flintwinters/headgames/headgames.kicad_sch

## KiCad design headgames.kicad_sch (2026-08-09)

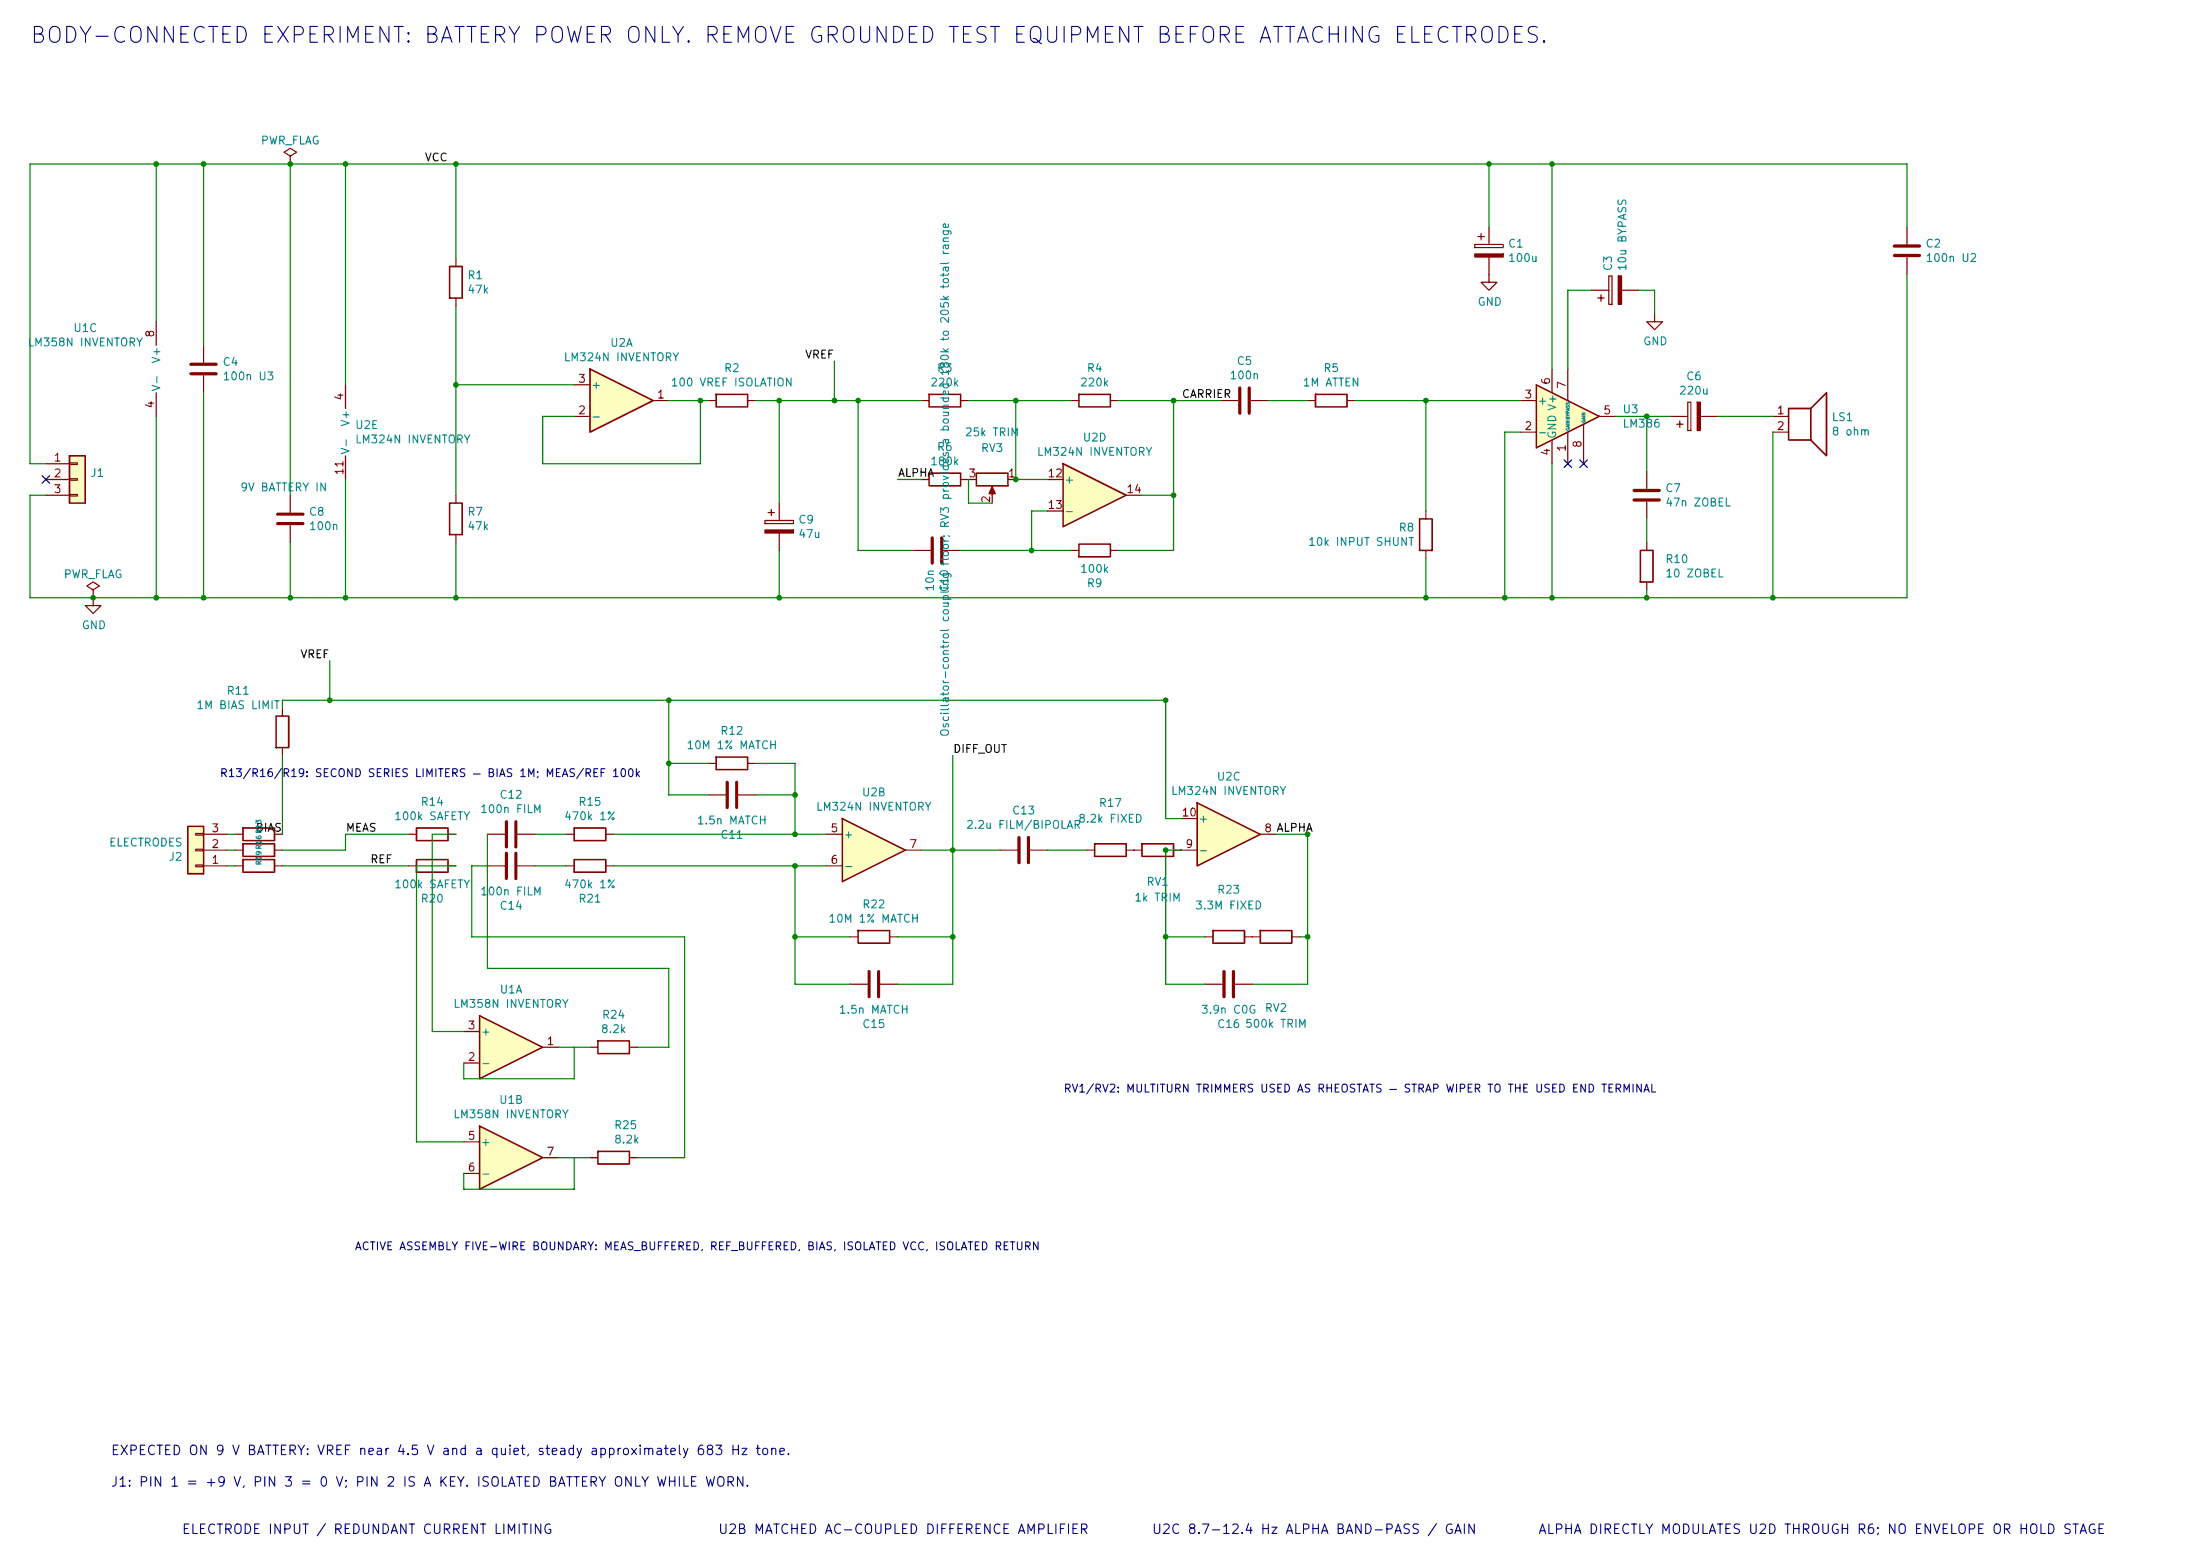
[picture p1: schematic headgames.kicad_sch]

Parts:
C1: 100u
C2: 100n U2
C3: 10u BYPASS
C4: 100n U3
C5, C8: 100n
C6: 220u
C7: 47n ZOBEL
C9: 47u
C10: 10n
C11, C15: 1.5n MATCH
C12, C14: 100n FILM
C13: 2.2u FILM/BIPOLAR
C16: 3.9n C0G
J1: 9V BATTERY IN
J2: ELECTRODES
LS1: 8 ohm
R1, R7: 47k
R2: 100 VREF ISOLATION
R3, R4: 220k
R5: 1M ATTEN
R6: 180k
R8: 10k INPUT SHUNT
R9: 100k
R10: 10 ZOBEL
R11: 1M BIAS LIMIT
R12, R22: 10M 1% MATCH
R13: 1M BIAS SAFETY B
R14, R20: 100k SAFETY
R15, R21: 470k 1%
R16: 100k MEAS SAFETY B
R17: 8.2k FIXED
R19: 100k REF SAFETY B
R23: 3.3M FIXED
R24, R25: 8.2k
RV1: 1k TRIM
RV2: 500k TRIM
RV3: 25k TRIM
U1: LM358N INVENTORY
U2: LM324N INVENTORY
U3: LM386

Connections:
ALPHA: C16.1, R6.2, RV2.1, U2.8
BIAS: R11.2, R13.1
CARRIER: C5.2, R4.1, R9.1, U2.14
DIFF_OUT: C13.2, C15.1, R22.1, U2.7
GND: C1.2, C2.2, C3.2, C4.2, C8.2, C9.2, J1.3, LS1.2, R7.2, R8.2, R10.2, U1.4 (V-), U2.11 (V-), U3.2 (-), U3.4 (GND)
MEAS: R14.2, R16.1
unnamed: C3.1, U3.7 (BYPASS)
unnamed: C5.1, R5.2
unnamed: C6.1, C7.1, U3.5
unnamed: C6.2, LS1.1
unnamed: C7.2, R10.1
unnamed: C10.1, R9.2, U2.13 (-)
unnamed: C11.1, R12.1, R15.1, U2.5 (+)
unnamed: C12.1, R15.2
unnamed: C12.2, R24.1
unnamed: C13.1, R17.2
unnamed: C14.1, R21.2
unnamed: C14.2, R25.1
unnamed: C15.2, R21.1, R22.2, U2.6 (-)
unnamed: C16.2, R23.2, RV1.1, U2.9 (-)
unnamed: J2.1, R19.2
unnamed: J2.2, R16.2
unnamed: J2.3, R13.2
unnamed: R1.2, R7.1, U2.3 (+)
unnamed: R2.2, U2.1, U2.2 (-)
unnamed: R3.1, R4.2, RV3.1, U2.12 (+)
unnamed: R5.1, R8.1, U3.3 (+)
unnamed: R6.1, RV3.2, RV3.3
unnamed: R14.1, U1.3 (+)
unnamed: R17.1, RV1.2
unnamed: R20.1, U1.5 (+)
unnamed: R23.1, RV2.2
unnamed: R24.2, U1.1, U1.2 (-)
unnamed: R25.2, U1.6 (-), U1.7
REF: R19.1, R20.2
VCC: C1.1, C2.1, C4.1, C8.1, J1.1, R1.1, U1.8 (V+), U2.4 (V+), U3.6 (V+)
VREF: C9.1, C10.2, C11.2, R2.1, R3.2, R11.1, R12.2, U2.10 (+)

Notes on the sheet:
ALPHA DIRECTLY MODULATES U2D THROUGH R6; NO ENVELOPE OR HOLD STAGE
EXPECTED ON 9 V BATTERY: VREF near 4.5 V and a quiet, steady approximately 683 Hz tone.
U2B MATCHED AC-COUPLED DIFFERENCE AMPLIFIER
R13/R16/R19: SECOND SERIES LIMITERS — BIAS 1M; MEAS/REF 100k
ACTIVE ASSEMBLY FIVE-WIRE BOUNDARY: MEAS_BUFFERED, REF_BUFFERED, BIAS, ISOLATED VCC, ISOLATED RETURN
BODY-CONNECTED EXPERIMENT: BATTERY POWER ONLY. REMOVE GROUNDED TEST EQUIPMENT BEFORE ATTACHING ELECTRODES.
ELECTRODE INPUT / REDUNDANT CURRENT LIMITING
U2C 8.7-12.4 Hz ALPHA BAND-PASS / GAIN
J1: PIN 1 = +9 V, PIN 3 = 0 V; PIN 2 IS A KEY. ISOLATED BATTERY ONLY WHILE WORN.
RV1/RV2: MULTITURN TRIMMERS USED AS RHEOSTATS — STRAP WIPER TO THE USED END TERMINAL
