flintwinters/headgames/(commit log)

2026-08-08 Establish project guidance and repeatable verification entrypoint
    Document the battery-only analog-feedback motivation, the MVP signal-chain architecture, and the major validation tasks in a concise root AGENTS.md. Make the intended LM324 compromise and its future replacement boundary explicit so later refinements do not accidentally redefine the experiment.
    Add a Typer/Rich manage.py root command, locked Python project dependencies, and local-environment ignores. This creates the required durable location for circuit calculations and engineering checks before schematic values are introduced.
2026-08-08 Provide a safe, immediately viewable audio checkpoint schematic
    Replace the unusable hand-authored legacy KiCad attempt with a clean pin-numbered SVG schematic for the first construction checkpoint only: six-AA battery supply, buffered LM324 virtual ground, LM324 relaxation oscillator, volume control, LM386 output stage, and 8-ohm speaker.
    Keep electrodes explicitly out of this checkpoint and make the battery-only boundary prominent. Document how to export the SVG to PDF, ignore generated viewer/project artifacts, and state that the rejected legacy sheet must not be used for construction.
    Verify the SVG as well-formed XML, render and visually inspect both PNG and PDF outputs, run the proje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
2026-08-08 Add loadable KiCad schematic using only installed stock symbols
    Create the battery-reference, LM324 carrier, and LM386 speaker checkpoint as a KiCad schematic referencing the official Device, Switch, Amplifier_Operational, Amplifier_Audio, and power libraries. Remove every project-authored substitute symbol and keep the electrode path explicitly out of this first safe construction checkpoint.
    Add a portable project symbol-library table based on KICAD9_SYMBOL_DIR and document headgames.sch as the primary project artifact. Verify that KiCad 9.0.9 loads the sheet and exports it through kicad-cli without a parser failure, and pass repository whitespace checks.
    [headgames.sch]
2026-08-08 Correct checkpoint supply, oscillator, and LM386 connectivity
    Remove the battery and switch symbols so BAT+ and GND are explicit externally wired rails, matching the intended construction assumption.
    Reconnect C10 directly between the U1D pin-13 timing node and VREF, clean up the R18/R19 attenuator so R19 shunts the LM386 pin-3 input node to ground, and retain C13 as the local 100 nF U2 supply bypass across BAT+ and GND.
    Move C12 to LM386 pin 7 as the bypass capacitor with its positive terminal toward the bypass pin and ground its negative terminal. Correct U2 supply wiring to pins 6 and 4, and mark gain pins 1 and 8 with explicit no-connect flags. Verify that KiCad CLI loads and exports t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
    [headgames.sch]
2026-08-08 Clarify R19 as the LM386 input shunt
    Move R19 farther below the audio input signal path and provide separate vertical leads between the input junction, resistor, and ground rail. Add an explicit junction at the branch to U2 pin 3 and label the part as the input shunt so the drawing no longer suggests that an unrelated wire passes over the resistor.
    Verify the revised schematic exports successfully through KiCad CLI and passes repository whitespace checks.
    [headgames.sch]
2026-08-08 Add reserved three-pin electrode header
    Add J1 using KiCad's stock Connector_Generic:Conn_01x03 symbol and assign pin 1 to MEAS, pin 2 to REF, and pin 3 to BIAS. Keep all three electrode nets isolated from the current audio checkpoint and label the connector as reserved for the future acquisition stage so it cannot be mistaken for an active body connection.
    Register the installed Connector_Generic library through the portable project symbol table, then verify that KiCad CLI loads and exports the revised schematic and that whitespace checks pass.
    [headgames.sch]
2026-08-08 Wire electrode header into complete analog acquisition chain
    Connect J1 pin 1 MEAS and pin 2 REF through symmetric 100 kΩ safety resistors, 100 nF film coupling capacitors, and 470 kΩ input resistors to U1B. Add matched 10 MΩ/1.5 nF reference and feedback impedances so U1B provides an AC-coupled differential front end centered on VREF. Connect J1 pin 3 BIAS to VREF through a 1 MΩ current-limiting resistor.
    Use U1C for the alpha-selective gain stage with a 2.2 µF/6.8 kΩ high-pass input and 3.3 MΩ/4.7 nF parallel feedback. Add a stock Schottky detector symbol with a 220 kΩ/1 µF envelope network and route ENV into the existing U1D oscillator control input instead of tying that control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
    [headgames.sch]
2026-08-08 Rename positive supply net from BAT+ to VCC
    Use the conventional VCC net name for the externally wired positive supply rail while preserving the schematic's explicit battery-only safety requirements for operation with electrodes attached. Verify the renamed schematic exports successfully through KiCad CLI and passes whitespace checks.
    [headgames.sch]
2026-08-08 Correct stale ENV reference annotation
    Replace the obsolete statement that ENV equals VREF with the accurate invariant: ENV is referenced to VREF and driven by the envelope detector. Apply the same surgical text correction to the user's newly organized native KiCad schematic without staging or otherwise absorbing their broader untracked work.
    Verify the native headgames.kicad_sch loads and exports successfully through KiCad CLI and preserve all existing component placement, wiring, UUIDs, and organizational changes.
    [headgames.sch]
2026-08-08 Make ENV wiring rule explicit on the schematic
    Replace the ambiguous ENV annotation with a direct construction rule: do not wire ENV directly to VREF; R12 and C9 return the envelope node to VREF, D1 drives it, and ENV feeds R16. Apply the identical surgical annotation to the user's organized native KiCad sheet without staging or altering its broader untracked layout work.
    Verify that the native schematic continues to load and export through KiCad CLI and that repository whitespace checks pass.
    [headgames.sch]
2026-08-08 Make the native KiCad schematic the sole design authority
    Remove the obsolete legacy headgames.sch that was retained during migration and add the organized native headgames.kicad_sch as the only schematic source. This eliminates conflicting edits, stale annotations, and uncertainty over which file should be opened or built.
    Preserve the user's native KiCad organization and all current circuit content, including the explicit ENV wiring annotation. Update the README to name the native file as authoritative, then verify it independently by exporting both PDF and BOM through kicad-cli and passing repository whitespace checks.
    [headgames.kicad_sch, headgames.sch]
2026-08-08 Track the native KiCad project and discard stale session metadata
    Stop ignoring headgames.kicad_pro and add the valid KiCad 9 project configuration alongside the sole native headgames.kicad_sch. Remove the local .kicad_prl session cache that retained editor state from the deleted legacy schematic and caused KiCad to prompt for headgames.sch.
    Preserve the active native schematic lock file, validate the project JSON, verify the native schematic exports through kicad-cli, and pass repository whitespace checks. Users should now open headgames.kicad_pro rather than the obsolete recent-file entry for headgames.sch.
2026-08-08 Refresh concise project philosophy and architectural guidance
    Update AGENTS.md to identify the native KiCad schematic as the sole authority and capture the durable MVP architecture: three-electrode battery-powered acquisition, LM324 reference/differential/filter/carrier roles, passive ENV detector, LM386 output, and an entirely analog feedback loop.
    Make the ENV/VREF invariant and body-connected electrical safety boundary explicit, retain the instrumentation-amplifier upgrade boundary, and reduce current work to the three major validation phases. Remove the inaccurate claim that placeholder manage.py calculations are jointly authoritative and add compact KiCad/source-of-truth workflow guida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
2026-08-08 Document the board as externally wired
    Remove all tracked references to battery or AA-cell operation from the authoritative schematic, project guidance, README, and build-now visual. Rename the illustrated supply rail consistently to VCC and depict the source as an isolated wired 9 V DC input.
    Retain the body-connected safety invariant in terms appropriate to a wired board: the external DC supply must remain isolated from mains earth and USB while electrodes are attached, and grounded or non-isolated equipment must be disconnected.
    Verification: python3 manage.py test; xmllint --noout BUILD_NOW.svg; git grep confirms no battery, BAT+, or AA terminology remains in tracked sources; kicad-cli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
    [headgames.kicad_sch]
2026-08-08 Fix LM386 carrier input connectivity
    Remove the unintended ground leg from the attenuated carrier node so the C11/R18 signal path reaches LM386 pin 3. Preserve the intended R19 input shunt and grounded inverting input, while giving C14 an independent local ground symbol so supply decoupling no longer relies on the faulty shared wire.
    Replace the placeholder project test with a KiCad-netlist connectivity check. The root manage.py entrypoint now verifies that R18 and R19 meet U2 pin 3, that U2 pin 2 remains grounded, that pin 3 is not grounded, and that C14 still returns to ground. Temporary verification artifacts are created and removed within the project directory.
    Verified with python3 ma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
    [headgames.kicad_sch]
2026-08-08 Restore LM386 input path after schematic relayout
    Accept the newly saved authoritative KiCad layout while restoring the carrier-to-audio connectivity invariant lost during the overwrite. Remove the ground leg that shorted the R18/R19/U2 pin 3 node, leaving R19 as the intended input shunt and U2 pin 2 as the grounded inverting input.
    Separate C14 supply decoupling from the signal path by returning its negative terminal through a dedicated GND symbol. This prevents the bulk-decoupling connection from recreating a conductive short between the LM386 non-inverting input and ground.
    Verified the current schematic with python3 manage.py test, a direct kicad-cli netlist export, kicad-cli ERC, Pyth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
    [headgames.kicad_sch]
2026-08-08 Isolate buffered VREF from reservoir capacitance
    Insert R17 as a 100 ohm series isolation resistor between the U1A voltage-follower output and the distributed VREF rail. Keep U1A feedback connected on the amplifier side of R17 so the 47 uF C1 reservoir cannot sit inside the follower loop or directly load the LM324 output.
    Extend the root manage.py connectivity verification to require the follower feedback topology, both sides of R17, and electrical separation between C1 and U1A's output. This turns the stability boundary into a durable schematic invariant.
    Verified with 'uv run ./manage.py test', KiCad 9 netlist export through the test harness, and 'git diff --check'. KiCad ERC still repor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
    [headgames.kicad_sch]
2026-08-08 Bound LM386 carrier drive below clipping demand
    Increase R18 from 100 kohm to 1 Mohm while retaining the 10 kohm input shunt and AC coupling. With the LM386's specified 50 kohm input resistance included in parallel with R19, the gain-20 amplifier now requests approximately 0.165 V/V of speaker-output swing for each volt of carrier swing instead of exceeding the available battery rail.
    Refactor schematic extraction to return component values together with connectivity, add compact resistor-value parsing, and calculate the complete source-divider-plus-LM386 gain in the root verification command. Fail verification if the ideal carrier-to-output demand exceeds 0.2 V/V so future value edits cann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
    [headgames.kicad_sch]
2026-08-08 Stabilize LM386 output with series Zobel network
    Add C16 at 50 nF and R20 at 10 ohms as a series branch from LM386 pin 5 to ground, matching the output stabilization network in the manufacturer's gain-20 application. Branch before the speaker coupling capacitor so the network damps high-frequency load reactance without placing DC across the speaker or turning C16 into a direct capacitive output load.
    Extend manage.py verification to require C16 on the amplifier output net, the isolated C16/R20 midpoint, R20's ground return, and the authoritative 50 nF and 10 ohm values. This prevents topology regressions such as a parallel RC branch or a capacitor connected directly from output to ground.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
    [headgames.kicad_sch]
2026-08-08 Define the isolated 9 V battery power contract
    Replace the schematic's ambiguous loose VCC and ground stubs with a keyed three-position J2 battery interface. Pin 1 is the positive 9 V feed, pin 3 is battery return, and pin 2 is deliberately unused as a polarization key. Add source flags at the connector-fed rails so KiCad ERC can distinguish an intentional external source from an accidentally undriven power network.
    Make the operating voltage and isolation requirement explicit in both the connector metadata and the on-sheet safety notes. This removes guesswork around LM324 headroom, LM386 supply range, capacitor polarity, and electrode bias-current bounds while retaining the project's batte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
    [headgames.kicad_sch]
2026-08-08 Harden the physiological pickup and alpha detector path
    Replace the authoritative LM324N population with the pin-compatible TLC274CN low-bias CMOS quad amplifier. The 9 V single-supply topology and existing package boundary remain intact, while picoamp-scale input bias avoids the large 10 MΩ acquisition-network error inherent to the bipolar LM324. Retain LM324 only as an explicitly documented artifact-test fallback rather than the physiological pickup configuration.
    Separate the U1C alpha-band corners by changing C7 to 2.7 uF and C8 to 3.9 nF. With the existing 6.8 kΩ input and 3.3 MΩ feedback resistors, the calculated high-pass and low-pass corners are 8.67 Hz and 12.36 Hz instead of tw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
    [headgames.kicad_sch]
2026-08-08 Restore the inventory-first LM324N implementation
    Undo the unavailable TLC274CN population decision while preserving the independently valid power-interface, alpha-band, detector, and verification improvements. Restore LM324N consistently across all five schematic units, the title block, README, and architectural guidance.
    Make the inventory constraint executable by changing the root verification entrypoint to require LM324N for U1. Document its bipolar input-bias, offset, and noise limitations honestly at the 10 MΩ acquisition impedance, and retain a clean future replacement boundary without making an unstocked part mandatory for the MVP.
    Verification: python3 manage.py test passes; KiCa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
    [headgames.kicad_sch]
2026-08-08 Separate the battery inlet from supply decoupling
    Move J2 into a dedicated inlet block at the far left of the schematic and route its positive and return conductors around the outside of the circuit. The keyed pin now has an isolated, visible no-connect marker, and neither battery conductor passes through a component body or field.
    Restore C2 as an independent vertical bypass branch directly between VCC and ground. Shorten J2's displayed value to avoid colliding with C2 while retaining the complete polarity, keying, and isolation contract in the connector description and the on-sheet safety annotation.
    Update the durable J2 value assertion to match the concise displayed field. Verification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
    [headgames.kicad_sch]
2026-08-08 Replace the passive alpha detector with an LM358N precision stage
    Use the inventory LM358N as a two-stage analog envelope front end. U3A now drives the existing 1N5711 inside its feedback loop so the op amp compensates the Schottky forward drop instead of requiring the filtered alpha signal to overcome it directly. Keep R12 and C9 as the authoritative 220 ms hold/release network referenced to VREF, and expose that held voltage as ENV_RAW.
    Use U3B as a unity-gain buffer between ENV_RAW and the carrier-control input. This prevents the oscillator summing resistor from loading the detector capacitor while retaining an entirely analog feedback path. Add C17 as local 100 nF LM358N supply decoupli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
    [headgames.kicad_sch]
2026-08-08 Add independent current limiting at every electrode connection
    Place a second physical series resistor immediately after each J1 electrode pin so a single resistor short cannot entirely remove the intended current limiting. MEAS and REF now each use two 100 kohm safety resistors for a nominal 45 microamp 9 V upper bound; BIAS uses two 1 Mohm resistors for a nominal 4.5 microamp upper bound.
    Keep the connector-side nets deliberately limited to J1 and the outer resistor, then join each outer resistor to the existing inner limiter on a separate circuit-side net. This makes the no-bypass invariant explicit in the native netlist rather than relying on annotations.
    Extend manage.py to verify the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
    [headgames.kicad_sch]
2026-08-08 Clarify the new detector and electrode safety annotations
    Replace long internal detector net names with compact DRV and HOLD labels so the precision-feedback connections remain legible on the A3 sheet. Shorten the D1 display value while retaining the exact 1N5711 part identity in both the schematic value and automated invariant.
    Keep the tightly spaced connector-side resistors identifiable by compact reference labels and add one authoritative callout stating their roles and values, rather than allowing three repeated long value strings to obscure the electrode wiring.
    Verified the rendered schematic visually after native SVG export, then reran python3 manage.py test for connectivity and ze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
    [headgames.kicad_sch]
2026-08-09 Add bounded alpha-band corner tuning
    Introduce fixed-plus-trimmer resistance in both alpha filter corner networks so calibration cannot remove the stage's limiting resistance. The high-pass uses 6.2 kOhm fixed plus a 1 kOhm multiturn trim for an approximately 8.19-9.51 Hz range with the existing 2.7 uF capacitor. The low-pass uses 3 MOhm fixed plus a 500 kOhm multiturn trim for an approximately 11.66-13.60 Hz range with the existing 3.9 nF capacitor.
    Represent each external three-terminal trimmer as a two-terminal rheostat in the authoritative schematic and add an explicit assembly instruction to strap the wiper to the used end terminal. This gives a defined failure tendency if wiper contac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
    [headgames.kicad_sch]
2026-08-09 Normalize adjustable filter parts to common values
    Replace the difficult-to-source 2.7 uF alpha high-pass capacitor with a common 2.2 uF film or bipolar value and compensate with an 8.2 kOhm fixed resistor. Together with the existing 1 kOhm trim this preserves a bounded approximately 7.86-8.82 Hz high-pass adjustment range.
    Replace the 3 MOhm low-pass resistor with the readily available 3.3 MOhm value. Retaining the 500 kOhm trim provides an approximately 10.74-12.37 Hz low-pass adjustment range that remains wholly above the maximum high-pass corner.
    Normalize the LM386 output stabilization capacitor from nominal 50 nF to standard 47 nF while retaining the 10 Ohm series resistor. Update th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
    [headgames.kicad_sch]
2026-08-09 Normalize the precision detector diode to 1N4148
    Replace the specialized 1N5711 low-level Schottky with the ubiquitous 1N4148 small-signal silicon diode. D1 remains inside the LM358 precision-detector feedback loop, so the amplifier compensates the higher silicon forward drop rather than imposing it as an envelope threshold.
    Prefer the 1N4148's low reverse leakage for the held envelope node. This keeps the detector release primarily controlled by the intentional 220 kOhm and 1 uF network instead of allowing a generic Schottky's leakage to become a significant parallel discharge path.
    Update the schematic description, architectural invariant, and durable component assertion. Preserve the wa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
    [headgames.kicad_sch]
2026-08-09 Add reproducible EEG-path AC circuit simulation
    Introduce a deterministic complex-impedance model of the matched acquisition
    and alpha-filter stages. Build the model from values exported from the sole
    authoritative KiCad schematic so that simulation cannot silently drift into a
    parallel circuit definition.
    Exercise every trimmer corner in the root manage.py test entrypoint, bound the
    predicted response peak and gain, and verify that a 200 uV peak differential
    fixture remains within conservative LM324 output headroom. Add simulate-eeg as
    the human-readable reporting command for representative 10-100 uV signals.
    The report intentionally exposes the important result that the cascaded
    response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
2026-08-09 Document system-level EEG simulation limits
    Extend the simulation regression to preserve the nominal full-cascade -3 dB
    span, rather than validating only individual RC corner calculations. Report
    that span alongside peak frequency and gain so future component changes reveal
    whether system selectivity actually improves.
    Document the 20 kohm electrode-source assumption, representative 10-100 uV
    peak fixtures, expected ALPHA-node amplitudes, and the ideal small-signal
    model's explicit exclusions. Record the central finding that the current
    3.69-14.71 Hz response is broad and peaks below alpha, leaving artifact,
    mains-pickup, tolerance, and real LM324 behavior for isolated bench testing.
    Also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
2026-08-09 Model alpha distinguishability under simultaneous artifacts
    Extend the schematic-driven frequency-domain solver from balanced differential
    inputs to the full ideal-op-amp nodal solution with independent MEAS and REF
    source impedances. This preserves common-mode-to-differential conversion caused
    by realistic electrode imbalance while retaining an exact regression against
    the original balanced transfer function.
    Add a deterministic time-domain model of the LM358 precision peak detector with
    the schematic-derived 0.22 second release. Introduce simulate-artifacts through
    the sole manage.py entrypoint and exercise a declared project-survival fixture:
    20 kohm/100 kohm electrode mismatch, 1 mV pea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
2026-08-09 Document matched acquisition pairs and common capacitor plan
    Promote the matched acquisition impedance pairs to an explicit assembly
    invariant: R12/R22, C11/C15, C12/C14, and the measured 474 kohm R15/R21 pair.
    Clarify that pair difference under consistent measurement matters more than
    nominal absolute value and that substituting both 474 kohm resistors changes
    nominal differential gain by less than one percent.
    Record the missing 1.5 nF inventory item and reject a direct 1 nF substitution,
    which would move the 10 MOhm feedback pole from roughly 10.6 Hz to 15.9 Hz and
    worsen the already broad artifact response. Establish matched parallel 1 nF and
    470 pF C0G parts as the common-value impleme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
2026-08-09 Prefer exact 1.5 nF networks built from common 1 nF parts
    Refine the inventory-first feedback-capacitor plan to use only the available
    common 1 nF value. At each original 1.5 nF location, place one 1 nF C0G part in
    parallel with a series pair of 1 nF C0G parts; the resulting C + C/2 network is
    exactly 1.5 nF nominally and preserves the intended 10.6 Hz feedback pole.
    Require selection of six capacitors by the measured equivalent capacitance of
    the two completed networks, since network-to-network matching controls
    common-mode rejection. Retain 1 nF plus 470 pF as a lower-part-count alternative
    when that common value is available, and require every physical capacitor to be
    represented in the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
2026-08-09 Model electrode-site unity buffers against artifact survival fixture
    Add a reversible active-electrode architecture model without modifying the
    authoritative KiCad schematic. Place each unity buffer after both electrode-side
    series safety resistors, reduce its cable end to a complex Thevenin source, and
    solve the existing acquisition/filter network with unequal electrode resistance
    and unequal cable capacitance. Include finite input capacitance, follower GBW,
    output resistance, input bias, and declared white voltage noise rather than
    assuming an ideal voltage source.
    Reuse the authoritative simultaneous artifact tones and peak-detector model so
    passive and active architectures face exactly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
2026-08-09 Validate planned dual-biquad alpha filter against artifact fixtures
    Add a mathematically synthesized cascade of two unity-center-gain second-order
    band-pass sections. Derive the 9.798 Hz geometric center and per-section Q of
    1.576 from explicit reciprocal 8 Hz and 12 Hz combined -3 dB boundaries rather
    than selecting informal RC corners. Preserve optional independent center and Q
    coefficient errors for each physical section.
    Apply the planned post-ALPHA filter to the existing passive-cable and active-
    electrode survival fixtures before the schematic-derived 0.22 second peak
    detector. Keep the upstream-headroom bound explicit because downstream
    filtering cannot recover a saturated acquisitio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
2026-08-09 Compress project guidance around authoritative decisions
    Reduce README.md and AGENTS.md from 2,123 words across 254 lines to 1,021
    words across 137 lines while preserving the knowledge that must evolve as a
    single project truth.
    Consolidate repeated simulation narratives into compact result tables covering
    the existing broad response, failed artifact fixture, active-electrode tradeoff,
    and passing two-biquad hypothesis including coefficient corners. Retain the
    fixture definition, 25 percent acceptance threshold, explicit model exclusions,
    and distinction between architectural evidence and build-ready hardware.
    Keep the isolated-battery rule, prohibited grounded connections, redundant
    per-e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
2026-08-09 Retract ideal-filter hardware acceptance claim
    Remove the abstract CascadedBandpass result from the root hardware acceptance path. The normalized transfer function remains useful as a synthesis oracle, but it no longer authorizes a physical circuit decision.
    Relabel the sharper-filter report and durable project evidence as IDEAL TARGET — NON-GATING. Preserve the previously measured 565%/1,046% nominal and coefficient-perturbation figures while explicitly identifying the physical synthesis, amplifier limits, noise, saturation, and recovery work that remains.
    This checkpoint intentionally leaves headgames.kicad_sch unchanged and excludes the user-modified headgames.kicad_pro and live KiCad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
2026-08-09 Add independently checked physical MFB filter network
    Encode the proposed post-ALPHA circuit as two explicit five-part multiple-feedback stages using 255 kΩ, 64.9 kΩ, 510 kΩ, and two 100 nF capacitors per stage. Keep the candidate outside the authoritative KiCad schematic.
    Solve each stage from its physical nodal equations with a finite single-pole LM358 model. Expose the summing and inverting nodes plus input, feedback, capacitor, and total output currents so later loading and stress checks operate on circuit quantities rather than an abstract coefficient model.
    Add an independent closed-form MFB transfer oracle and durable regressions establishing 9.798277 Hz center frequency, Q 1.569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
2026-08-09 Stress the physical filter and fail closed on SPICE incompatibility
    Add exhaustive enumeration of all 1,024 independent endpoints across the two five-part 1% resistor and 5% capacitor MFB stages. Add deterministic bounded sampling with the HEAD seed, explicit source/load currents, conservative output/common-mode margins, integrated resistor and amplifier noise, detector-hold variation, and an analytical overload-recovery bound.
    Add the build and non-gating abuse tiers behind manage.py. The build report evaluates the passive-electrode survival fixture end to end; the active architecture remains outside acceptance. The abuse report records the first explicit 100 mV differential overload bound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
2026-08-09 Record the physical stress failure and keep the schematic closed
    Update durable project evidence with the complete HEAD-seeded 1,024-corner and 20,000-sample Python results while labeling them partial, non-authorizing evidence. Record the decisive circuit-level failure: ngspice 44.2 cannot evaluate TI's official Rev. C PSpice macro-model, so the required simulator agreement does not exist.
    Document both physical-filter CLI tiers, the exact decimal form of seed 0x48454144, the first non-gating abuse boundary, and the proposed one-package LM358N MFB topology. Replace the completed synthesis task with the actual architectural blockers: compatible source-locked independent simulation and fuller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
2026-08-09 Bind EEG simulations to the authoritative schematic topology
    Expand the native KiCad netlist audit from component-value matching to a complete pin-by-pin proof of the simulated acquisition path. Verify both electrode safety chains, series coupling networks, U2B polarity, parallel feedback networks, DIFF_OUT, the U2C ALPHA input and feedback paths, VREF returns, and the intentionally open trimmer ends.
    Also require MEAS/REF safety-resistor symmetry because the simulator legitimately reduces the matched network to one parameter set. Every user-facing EEG, artifact, active-electrode, ideal-filter, and physical-stress command now validates this topology before evaluating circuit equations.
    Ver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
2026-08-09 Separate regression health from neurofeedback acceptance
    Rename the artifact and active-electrode checks as baseline regressions and report their two meanings independently: the documented 3.8%/2.8% behavior was reproduced, while the 25% neurofeedback criterion still fails. Successful report generation no longer presents an unqualified engineering pass.
    Make manage.py test a deterministic regression command that exits zero only when documented schematic, ERC, model, corner, and provenance expectations remain stable. Its terminal message explicitly disclaims neurofeedback and hardware acceptance.
    Add a distinct manage.py accept command for the full 20,000-sample physical candidate and manda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
2026-08-09 Model finite acquisition and physical precision-detector failure
    Add distinct conservative LM324 acquisition and LM358 detector limits covering finite DC gain and GBW, offset, bias current, common-mode range, output swing/current, slew rate, clipping, and overload recovery. Apply finite loop-gain correction to the schematic-verified acquisition response and include worst-case 10 MΩ bias/offset error in continuous-fixture headroom.
    Replace the ambiguous peak-detector name with an explicitly non-gating ideal envelope oracle. Add a stateful LM358/1N4148 detector that steps finite closed-loop response and slew, rail clipping and recovery, diode forward/output current, reverse leakage, junction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
2026-08-09 Model active electrodes in the physical MFB frontier
    Route the physical filter stress fixture through the declared electrode-site buffer model before applying the finite-A0/GBW LM324 acquisition response. This makes the gating Python model represent the current best candidate signal chain instead of the older passive-electrode baseline.
    Add a reusable nonideal active-electrode solver that preserves electrode-side safety resistance, buffer input and cable behavior, finite output impedance, and downstream acquisition loop-gain limitations. Rename the fixture and report title so future results state the tested architecture explicitly.
    Verified with the exhaustive 1,024 physical component corn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
2026-08-09 Record active-electrode MFB frontier evidence
    Update the project architecture and user-facing evidence table after running the complete 1,024-corner plus 20,000-seeded-build physical stress model with active electrode-site buffers.
    The revised frontier retains at least 851.2% modeled physical-detector ENV change, limits peak modeled output current to 2.131 mA, and improves the worst headroom result to -1.929 V. The hardware gate remains closed because conservative LM324 bias and offset through the 10 Mohm acquisition feedback still exceed available headroom.
    Document that active electrodes remove most cable/source-imbalance conversion but do not resolve the acquisition-stage DC error, and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
2026-08-09 Center the physical MFB frontier on nominal operation
    Replace the exhaustive component endpoints and broad 20,000-build stress sweep with one nominal build plus 2,000 reproducible near-nominal operating points. Bound the frontier to 8.8-9.2 V, +/-0.25% resistor movement, and +/-1% capacitor movement around the proposed values.
    Use room-temperature noise and typical LM324/LM358 electrical behavior. Correct acquisition DC headroom by recognizing that the AC-coupled 474 kohm input arms are open at DC and that matched 10 Mohm paths cancel common input bias current; model the residual 5 nA input offset current plus unity-gain 2 mV input offset instead of amplifying and adding full worst-case bia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
2026-08-09 Document the nominal physical frontier
    Replace the obsolete exhaustive-corner and broad-stress evidence with the active-electrode frontier's nominal plus 2,000 near-nominal operating points. Record the 8.8-9.2 V supply band, tight component movement, corrected acquisition DC balance, and passing Python-tier results.
    Update the architectural state so the remaining closed gate is independent simulator compatibility and validation rather than the removed artificial LM324 headroom failure. Remove the non-gating abuse workflow from user documentation and redirect the current acquisition task toward independent simulation and bench confirmation.
2026-08-09 Cross-check the nominal MFB frontier with ngspice
    Add a project-owned, source-locked LM324-N/LM358-N compatibility macro-model for the declared 9 V, VREF-centered, low-frequency operating frontier. Parameterize it from nominal datasheet behavior: 100 dB open-loop gain, 1 MHz GBW, 2 mV offset, 45 nA mean bias, 5 nA offset current, finite input impedances, a dominant pole, and finite output resistance.
    Keep the comprehensive TI PSpice model locked for provenance while using the deliberately scoped compatibility model for ngspice. Validate acquisition DC balance in a matched 10 Mohm fixture before comparing the two-stage MFB response at 2, 8, 10, 12, 30, and 60 Hz. Continue to gate rail and cu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
2026-08-09 Use realistic component tolerances in the MFB frontier
    Expand independent resistor movement from +/-0.25% to the specified +/-1% band and capacitor movement from +/-1% to +/-5%. These are ordinary assembled-part tolerance limits, so they remain part of the nominal operating/build case without restoring environmental or abuse stress scenarios.
    Lock both tolerance decisions into the root verification suite so a future edit cannot silently narrow the candidate frontier. Retain the seeded 2,000-build evaluation and explicitly document that it is a bounded sensitivity study rather than a statistical yield estimate.
    Verification: python3 manage.py simulate-filter-stress --tier build --samples 20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
2026-08-09 Fail circuit acceptance on KiCad/model boundary mismatches
    Introduce an explicit block-level reconciliation contract between the native KiCad implementation and the physical-frontier simulation. The comparison deliberately treats neither representation as globally authoritative: it recognizes the shared LM324 acquisition/ALPHA and LM358 detector, identifies the active electrode buffers and two MFB stages as model-only proposals, and identifies carrier control plus LM386 audio as schematic-only downstream circuitry.
    Add compare-physical-frontier as a durable Typer/Rich audit command and make hardware acceptance fail before numerical stress testing whenever the implementation boundaries diffe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
2026-08-09 Select OPA2192 and define the active-electrode cable boundary
    Replace the anonymous hypothetical unity buffers with one named dual OPA2192 serving MEAS and REF. Model the selected IC at 10 MHz GBW, 20 pA input bias, 6.4 pF input capacitance, and 10.5 nV/rtHz voltage noise while retaining a conservative 100 ohm output resistance.
    Define the worn active-electrode assembly as exactly five electrical conductors: buffered MEAS, buffered REF, passive BIAS, isolated battery VCC, and isolated battery return. Preserve the safety invariant that both 100 kohm resistors remain on the body side of each buffer, so cable capacitance is driven by the amplifier rather than the electrode impedance.
    Make the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
2026-08-09 Restrict active electrodes to the stocked LM358N
    Remove the unavailable OPA2192 from the design contract and model the electrode-site MEAS/REF buffers with one inventory LM358N dual amplifier. Declare the project amplifier inventory boundary explicitly as LM324N and LM358N so the active-buffer regression fails if a future candidate is introduced without an inventory decision.
    Use nominal LM358N behavior already employed elsewhere in the project: 1 MHz GBW, 45 nA input bias, 40 nV/rtHz voltage noise, 5 pF input capacitance, and 100 ohm modeled output resistance. Retain the approved five-conductor isolated assembly and the invariant that both safety resistors precede each input.
    Update gener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
2026-08-09 Add inventory-authoritative MFB network synthesis
    Parse the project BOM as an inventory union while treating blank quantity-on-hand fields as available but uncounted. Resolve each designator through the native KiCad value map so stale CSV comments cannot override the authoritative schematic.
    Introduce canonical series/parallel passive networks with deterministic enumeration, bounded physical part counts, and endpoint evaluation that moves each physical leaf by its own declared or conservative tolerance. Synthesize the proven MFB response lexicographically by response error, part count, and stable topology identity.
    Expose the audit as manage.py synthesize-mfb and make manage.py test prove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
    [headgames_bom.csv]
2026-08-09 Model wet and dry electrode interfaces explicitly
    Add Randles-style electrode profiles with series resistance and parallel charge-transfer resistance/capacitance. The wet Ag/AgCl profile is the gating default and the dry profile is separately selectable and explicitly informational.
    Thread the frequency-dependent complex interface through the electrode-site LM358 Thevenin model, retain deterministic half-cell, drift, motion, and excess-noise declarations, and preserve the historical active-electrode regression as a distinct legacy fixture.
    Model the required 100 ohm output isolation against both 150 pF and 250 pF cables. Gate the analytical follower estimate at 45 degrees phase margin and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
2026-08-09 Stress the synthesized physical MFB parts
    Route the deterministic inventory candidate into the wet-electrode stress runner so the reported and exercised networks share one authority. Remove the hard-coded unstocked nominal from Monte Carlo construction.
    Sample every resistor leaf independently using its BOM-derived tolerance and each unmarked 100 nF capacitor independently at the required ten-percent bound. Preserve seeded reproducibility while avoiding repeated synthesis inside the build loop.
    Retain the former closed-form MFB as an analytical oracle only; it no longer supplies physical build instances.
2026-08-09 Add a deterministic fail-closed TI ngspice translation
    Keep TI's Rev. B LMx58 source untouched and generate a separate ngspice artifact through a narrow reviewed translator. Convert only observed VSWITCH thresholds, behavioral IF and boolean OR expressions, and controlled-source TABLE data while retaining LIMIT expressions unchanged.
    Verify byte-for-byte regeneration from the hash-locked TI source and add a root characterize-ti-model command. The initial unity-follower characterization intentionally remains a hard gate: ngspice parses the translation but produces an out-of-rail operating point, so the comprehensive TI tier cannot grant acceptance.
    Retain the compact model solely for its ex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
2026-08-09 Keep model acceptance explicit and fail closed
    Rename the success verdict to MODEL ACCEPTANCE PASS so it cannot imply bench validation, physiological validation, or human-use clearance.
    Refresh the broad project state with the inventory-backed network, wet/dry interface boundary, physical-leaf tolerance policy, and the translated TI model's current out-of-rail characterization failure. Preserve KiCad/model mismatch and TI characterization as independent closed gates.
2026-08-09 Run TI characterization through ngspice PSpice compatibility
    Use ngspice's maintained PSpice translation path for the unchanged, hash-locked TI LMx58 Rev. B library. The compatibility frontend handles the vendor VSWITCH, behavioral IF, boolean, LIMIT, and TABLE semantics together rather than approximating them independently.
    The first unity-follower contract now converges correctly at 4.502147 V from a 4.5 V input with 0.800 mA supply current, replacing the invalid 9.739771 V result from the project-local textual conversion. Root regression tests remain green.
2026-08-09 Characterize the native TI LM358 model across physical limits
    Replace the incomplete project-local textual conversion with ngspice's maintained PSpice compatibility frontend while continuing to hash-lock and execute TI's original Rev. B source unchanged.
    Add durable root-managed DC, AC, input-bias, slew-rate, loaded-swing, low-frequency-noise, and isolated-cable transient fixtures. The working model measures 2.147 mV follower error, 0.350 mA quiescent current, 1.679 MHz follower bandwidth, 79.14 nA input bias, 0.321 V/us positive slew, 0.102-7.002 V loaded tracking, and 0.676 uV RMS noise from 0.5-100 Hz.
    Exercise both declared cable loads through the physical 100 ohm isolator. The 150 pF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
2026-08-09 Cross-check precision rectification with the TI LM358 model
    Add a durable transient fixture for the actual diode-in-feedback precision rectifier using TI's unchanged comprehensive model, a physical 1N4148 approximation, and the schematic 220 kohm/1 uF release network.
    Allow the vendor macro-model to settle from a UIC start before applying a deterministic 200 mV 10 Hz burst. The detector holds 203 mV and returns to ten percent in 0.410 seconds, independently confirming the Python detector's basic peak and recovery behavior.
    Keep cable stability as a separate failing contract: successful nonlinear detector behavior does not mask the 250 pF overshoot violation.
2026-08-09 Model zero-window analog sonification frontier
    Replace the acceptance model's envelope-centric endpoint with explicit continuous-time candidate metrics while retaining the historical detector regressions for comparison. Add fixed broadband, ALPHA, one-MFB, and report-only two-MFB families; compute unwrap-safe 8-12 Hz group delay, artifact discrimination, nondominance, and normalized ideal-point knee selection.
    Introduce a stateful finite-swing U2D relaxation oscillator and bounded LM386 behavioral stage using the datasheet gain-20, 50 kohm input, and 300 kHz bandwidth contract. Report carrier duty, carrier/sideband amplitudes, harmonics, speaker RMS current, clipping, latching, and node mar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
2026-08-09 Select stocked active-electrode cable isolation with TI model
    Parameterize the source-locked TI LMx58 cable transient so physical isolation values can be compared under identical 150 pF and 250 pF cable loads. Add a durable manage.py synthesis command that walks authoritative inventory values in ascending order and accepts only networks meeting the 20 percent overshoot and 1 ms settling contracts.
    The comprehensive model rejects the former 100 ohm assumption and selects the stocked 8.2 kohm resistor with zero measured overshoot and 8.4 microsecond worst settling. Keep phase-margin acceptance separate because a closed-loop step response is not an independent loop-return measurement.
2026-08-09 Reset project guidance around continuous-time sonification
    Make zero-window analog EEG sonification the explicit motivation and replace envelope-centered architectural claims with the selected bipolar oscillator-control path. Document measured group-delay and artifact-discrimination results for the broad, one-MFB, and historical two-MFB families, plus the bounded U2D and LM386 behavioral scope.
    Record the TI-model selection of stocked 8.2 kohm cable isolation without overstating closed-loop transient evidence as an independent phase-margin proof. Keep wet electrodes gating, dry electrodes informational, nonlinear audio claims bench-gated, and native-schematic acceptance closed until the det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
2026-08-09 Make simulation integrity a hard project invariant
    Require every simulation command to execute every advertised option, stimulus, case count, tolerance, phase, and gate. Require decision metrics at the declared physical endpoint and forbid silently substituting upstream proxies, block-level transients, or ideal transfer functions for end-to-end evidence.
    Require explicit model boundaries and omissions, fail-closed behavior for incomplete coverage, durable tests for case and phase coverage plus independent part movement, identical experiments across candidates, and immediate invalidation of placeholder or mislabeled results.
    Mark the existing sonification frontier, normalized knee, group-de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
2026-08-09 Replace proxy sonification with end-to-end speaker-current simulation
    Propagate deterministic silence, simultaneous motion/muscle/mains artifacts, and phased 50 microvolt alpha bursts through explicit wet/dry Randles electrode loading, active-buffer input and cable poles, asymmetric differential acquisition, candidate weighting, stateful finite-swing U2D oscillation, gain-20 LM386 bandwidth and clipping, the input coupling capacitor, the 220 microfarad output capacitor, the 8 ohm speaker, and Zobel current.
    Derive modulation only from carrier-referenced speaker-current spectra, using each paired condition's measured carrier so persistent oscillator phase offsets cannot masquerade as sustain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
2026-08-09 Reconcile KiCad with direct end-to-end sonification path
    Replace the historical LM358/1N4148 peak-detector path in the authoritative schematic with the physical path exercised by the speaker-current simulation. Repurpose the stocked LM358N as independent electrode-site MEAS and REF unity-gain buffers, preserve both redundant 100 kohm electrode safety resistors ahead of each buffer, and drive the acquisition inputs through independent selected 8.2 kohm cable-isolation resistors.
    Connect the ALPHA output directly and bipolarly to the U2D relaxation oscillator through R6, retaining the existing gain-20 LM386 input attenuation, output coupling, speaker load, and Zobel network. Document the five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
    [headgames.kicad_sch]
2026-08-09 Draw the active-electrode signal path explicitly
    Replace the MEAS_SITE, REF_SITE, MEAS_BUFFERED, and REF_BUFFERED same-sheet label jumps with continuous native KiCad wire segments. This makes both redundant input-limiter chains, LM358 followers, 8.2 kohm isolation resistors, and acquisition inputs traceable directly on the drawing instead of relying on net-label semantics that resemble open stubs.
    Add a root manage.py regression that rejects reintroduction of hidden label jumps on these safety-critical nets. Record explicit MEAS/REF continuity as an architectural invariant in AGENTS.md.
    Verification: kicad-cli ERC completed with 0 errors and 0 warnings; UV_CACHE_DIR=.uv-cache uv run python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
    [headgames.kicad_sch]
2026-08-09 Commit KiCad project state and keep generated artifacts out of Git
    Preserve the current KiCad symbol-fields table configuration in headgames.kicad_pro, including the Description and item-number columns produced by the schematic editor.
    Ignore project-local KiCad session files, lock files, automatic backup/history directories, and Python bytecode caches. Remove the existing generated history repository, bytecode cache, KiCad backup archives, private project-local settings, and stale project lock so the working tree reflects only durable source state.
    Verification: kicad-cli ERC reported 0 errors and 0 warnings; UV_CACHE_DIR=.uv-cache uv run python manage.py test passed; git diff --check pas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
2026-08-09 Make both LM358 follower connections electrically explicit
    Remove the duplicate overlapping output wires at U1A and U1B. Split each output conductor at its feedback branch so the output pin, isolation resistor, and inverting-input return meet at the same literal wire endpoint, with an explicit junction. This avoids relying on KiCad's ambiguous endpoint-on-overlap behavior.
    Reroute the MEAS_BUFFERED and REF_BUFFERED returns so they no longer overlay the existing acquisition-stage conductors. The revised drawing keeps the core path continuous while avoiding positive-length collinear overlaps.
    Add a root-level schematic geometry regression that scans every native KiCad wire segment and reject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
    [headgames.kicad_sch]
2026-08-09 rm bom
    [headgames_bom.csv]
2026-08-09 Maximize pre-bench simulation evidence and standardize on KiCad 9
    Restore the authoritative schematic to KiCad 9 format as explicitly required. Preserve the explicit MEAS/REF active-buffer paths while splitting both LM358 follower outputs at literal shared endpoints and routing the acquisition returns without overlapping collinear wires. KiCad 9.0.9 now loads the file natively, exports its netlist, and reports zero ERC violations.
    Remove the prior 100 ohm analytical cable-margin assertion because it neither represented schematic R24/R25 nor computed a valid return ratio. Add a KiCad-backed command that exercises the actual 8.2 kohm ±5 percent and 150/250 pF TI transient corners. Those four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
    [headgames.kicad_sch]
2026-08-09 Establish fail-closed alpha weighting redesign evidence
    Add a reproducible end-to-end redesign experiment that compares the existing alpha stage and one- and two-MFB extensions across the exact 100k, 68k, and 47k oscillator-control resistor set. Reuse identical wet-electrode physical builds, deterministic noise, and all 16 stimulus phases for every alternative, measure at speaker current, enforce exact case counts, and report group delay, modulation, artifact rejection, node margin, current, and the first failing gate.
    Promote alpha-to-artifact discrimination from a ranking metric to a mandatory per-phase gate. This rejects the present first-order stage and the single-MFB extension instead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
2026-08-09 Add fail-closed broadband EEG redesign campaign
    Introduce an explicit physical proposal for continuous 1–30 Hz control rather than reusing alpha-named component fields as an undocumented flat-gain shortcut. Model the U2C replacement as a VREF-centered inverting gain stage and represent the Q=8 60 Hz active notch with independent resistor and capacitor leaves.
    Retune the modeled differential acquisition capacitors to gentle nominal 1 Hz and 30 Hz edges while preserving the authoritative matched resistor ratios and all existing electrode, buffer, cable, oscillator, LM386, coupling, Zobel, and speaker-load behavior. Reuse the stateful speaker-current endpoint for every wanted and rejection t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
2026-08-09 Record broadband checkpoint and strengthen campaign rejection tests
    Document the model-only broadband architecture alongside the still-authoritative alpha schematic, including the exact two-build campaign scope, bounded delay and notch observations, omitted slow endpoint coverage, absent active-notch device leaves, and the reason no physical values may be selected yet.
    Extend the durable root regression suite with a complete synthetic per-frequency campaign fixture and deliberate missing-frequency rejection in addition to duplicate identity rejection. This ensures case totals cannot conceal an omitted requested frequency while keeping all durable verification behind manage.py.
    Keep the cur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
2026-08-09 Standardize broadband proposal on common passive values
    Replace the awkward 332 kΩ/8 nF abstract-notch proposal with a physically expressible active twin-T vocabulary based on repeated 390 kΩ and 6.8 nF parts. The half-resistance branch can use two 390 kΩ resistors in parallel and the double-capacitance branch can use two 6.8 nF capacitors in parallel, avoiding special 195 kΩ and 13.6 nF purchases.
    Represent Q with independently moved 20 kΩ and 620 kΩ positive-feedback divider leaves, giving Q=8 exactly from the twin-T relationship instead of storing an unexplained scalar. Retune the differential feedback edge from uncommon 530 pF to common 510 pF while retaining 330 nF input capacito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
2026-08-09 Add bounded oscillator modulation rheostat
    Replace the fixed 220 kΩ ALPHA-to-U2D coupling resistor with a 68 kΩ R6 floor in series with a 250 kΩ RV3 external linear rheostat. The fixed resistor prevents a zero-resistance control setting while the rheostat exposes a practical 68–318 kΩ adjustment range for carrier modulation strength.
    Represent RV3 using the schematic's established two-terminal external-rheostat convention and explicitly instruct builders to strap the wiper to the R6 end. Preserve the drawn signal-path continuity by placing RV3 directly in the former R6-to-U2D wire segment.
    Teach the behavioral model to derive its midpoint coupling resistance from both physical schema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
    [headgames.kicad_sch]
2026-08-09 Constrain oscillator rheostat to a useful local interval
    Replace the overly broad 68–318 kΩ oscillator-control adjustment with a 180 kΩ fixed R6 and a 25 kΩ RV3, yielding a bounded 180–205 kΩ total resistance. This keeps the complete control-sensitivity span near 14 percent while making every setting approximately 7–22 percent stronger than the former fixed 220 kΩ coupling.
    The small rheostat contribution also bounds sensitivity to its end-to-end tolerance: even a 10 percent RV3 error changes total series resistance by no more than about 1.2 percent. Preserve the fail-safe wiper strap and the explicit series topology.
    Update schematic-derived model invariants and architectural g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
    [headgames.kicad_sch]
2026-08-09 Show all oscillator rheostat pins explicitly
    Replace RV3's two-terminal resistor abstraction with KiCad's stock three-pin R_Potentiometer symbol so the physical potentiometer terminals and wiper are visible in the authoritative schematic.
    Connect terminal 1 toward the U2D oscillator input, terminal 3 toward the 180 kΩ R6 floor, and explicitly strap wiper terminal 2 to terminal 3. This preserves the intended fail-safe rheostat behavior: loss of wiper contact tends toward the full 25 kΩ track resistance instead of opening the modulation path.
    Strengthen the native topology check to require R6, RV3 pin 3, and RV3 wiper pin 2 on exactly the same net while retaining the independent assertion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
    [headgames.kicad_sch]
2026-08-09 Model the complete physical broadband twin-T
    Replace the ideal second-order notch polynomial with a nodal solution of the realizable active twin-T network. Represent both 390 kΩ series arms, both independently moved 390 kΩ leaves forming the 195 kΩ shunt, both 6.8 nF series arms, both independently moved 6.8 nF leaves forming the 13.6 nF shunt, and the 20 kΩ/620 kΩ positive-feedback divider.
    Compute the buffered twin-T output from the physical admittance matrix before applying the flat U2C gain. This makes center-frequency and notch-depth errors respond to every physical leaf instead of assuming perfect component ratios hidden behind an ideal transfer function.
    Extend deterministic sp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
2026-08-09 Enforce a 600-line Python module ceiling
    Add Pylint as a locked development dependency and configure its too-many-lines rule as a focused, recursive 600-physical-line gate. Expose the gate through the sole root Typer entrypoint as ./manage.py lint, disable Pylint persistence so validation does not depend on a writable user cache, and recursively inspect every non-hidden Python module so subpackages cannot evade the limit.
    Split the 2,700-line manage.py monolith by authoritative concern: shared schematic/model construction, selected and broadband sonification campaigns, electrode characterization, physical-filter synthesis, vendor-SPICE characterization, and native schematic checks. Keep man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
